brechtg111/museum-lijnvolgerV2/documenten/Eindverslag._finaledocx.docx

# Eindverslag

Museum Lijnvolger V2 | Brecht Gullentops | 2025-2026

## Opdracht

Tijdens dit project heb je niet alleen gewerkt aan een technisch eindresultaat, maar ook aan je ontwikkeling als toekomstige professional. In dit eindverslag blik je terug op het volledige traject en reflecteer je kritisch op je eigen functioneren binnen het team.

Dit verslag vormt een persoonlijke en onderbouwde reflectie op jouw leerproces. Het is geen herhaling van je technische documentatie, maar een verdieping op hoe jij het project hebt ervaren, welke keuzes je hebt gemaakt en hoe je bent gegroeid.

## Doel van deze opdracht

Met dit eindverslag toon je aan dat je:

- Bewust kan reflecteren op je eigen handelen
- Inzicht hebt in je sterktes en werkpunten
- Je ontwikkeling kan koppelen aan concrete ervaringen
- Kritisch kan terugblikken op samenwerking en projectaanpak
- Gericht kan nadenken over je verdere groei

## Link met de tussentijdse evaluatie

In je verslag wordt verwacht dat je expliciet terugkoppelt naar je tussentijdse evaluatie:

- Welke werkpunten had je toen geformuleerd?
- Hoe heb je hieraan gewerkt?
- Welke vooruitgang heb je geboekt?
- Wat blijft nog een aandachtspunt?

Deze link is essentieel en wordt meegenomen in de beoordeling.

## Belangrijke verwachtingen

Een goed eindverslag:

- Bevat concrete voorbeelden uit het project
- Is eerlijk en kritisch, niet enkel positief
- Gaat verder dan beschrijven en focust op reflectie (waarom, hoe, wat nu?)
- Toont duidelijk je persoonlijke groei

## Praktisch

- Gebruik het voorziene template
- Werk gestructureerd volgens de opgegeven onderdelen
- Zorg voor een duidelijke en verzorgde formulering

## Evaluatiecriteria

Dit verslag wordt beoordeeld op:

- Diepgang van reflectie
- Concreetheid en onderbouwing
- Inzicht in eigen functioneren
- Link met de tussentijdse evaluatie
- Professionele houding en kritische ingesteldheid

## Jouw verslag

Dit project draaide om het bouwen van een autonoom voertuig voor het Mercedes-Benz museum in Stuttgart. Het wagentje moest een zwarte lijn volgen, obstakels ontwijken en draadloos communiceren via MQTT. Technisch gezien was het een boeiend project, maar terugkijkend leer ik minstens evenveel uit hoe ik het project heb aangepakt als uit de technische inhoud zelf.

Tijdens de tussentijdse evaluatie had ik als werkpunt geformuleerd dat ik eerder had moeten beginnen met coderen in plaats van te lang te wachten op de hardware. In de tweede helft van het project heb ik dit aangepakt door parallel te werken: terwijl de PCB werd ontworpen, schreef ik al de rijlogica en de MQTT-integratie. Dat leverde merkbaar meer resultaat op in minder tijd. Toch blijft planning een aandachtspunt voor mij: ik onderschat nog regelmatig hoe lang debuggen duurt.

Een concreet moment waaruit ik veel heb geleerd, was het oplossen van de schommelende batterijmeting. Het percentage sprong willekeurig tussen 30 en 80 procent, wat het systeem onbetrouwbaar maakte. In eerste instantie dacht ik aan een fout in de code, maar na systematisch analyseren bleek het een hardwareprobleem: de motoren veroorzaakten elektromagnetische ruis op de ADC-pin. Ik heb dit opgelost met 16-sample averaging, een meetinterval van 5 seconden en een hysteresieteller voor de noodstop. Dit heeft me geleerd om bij onverwacht gedrag altijd eerst de hardware te verdenken voor ik de code aanpas.

Mijn sterkste punt tijdens dit project was het systematisch aanpakken van problemen. Wanneer iets niet werkte, zocht ik gericht naar de oorzaak in plaats van willekeurig dingen te veranderen. Dat resulteerde in duurzame oplossingen, zoals de noodstop die pas activeert na drie opeenvolgende kritieke metingen. Ik merk dat ik hierin gegroeid ben ten opzichte van eerdere projecten, waar ik sneller gefrustreerd raakte.

Een werkpunt blijft de documentatie: ik liet die te lang liggen en merkte op het einde dat GPIO-pinnummers, bestandsnamen en weerstandswaarden niet meer klopten met de werkelijkheid. Dit kostte onnodige tijd om recht te zetten. Voortaan wil ik documentatie bijhouden als een levend document, parallel aan de ontwikkeling.

Dit project heeft me geleerd dat technische kennis alleen niet volstaat. Het vermogen om gestructureerd te werken, fouten te analyseren en documentatie up-to-date te houden zijn minstens even belangrijk. Dat zijn vaardigheden die ik ook in een professionele context dagelijks zal nodig hebben.
