brechtg111/museum-lijnvolgerV2/documenten/eindevaluatie.xlsx

IoT Project
Houd er rekening mee dat alles in deze periode gebeurt onder begeleiding van een mentor en de focus in grote mate ligt op het leren en het leerproces van de student. Je houdt hiermee ook rekening bij uw beoordeling.
IoT-technicus (70% van de punten)
We evalueren de student in verschillende rollen: als IoT-technicus, als teamlid, als communicator en als groeiende professional. Elke rol omvat een aantal leerdoelen. Duid voor elk leerdoel de relevante beoordeling aan (zwak, voldoet bijna, voldoet, echt goed, overtreft de verwachtingen). Als het leerdoel niet van toepassing is in de specifieke context, duidt u N.V.T. aan. Tegen het einde van het werkplekleren moeten de opgesomde leerdoelen zoveel mogelijk aan bod komen. Na het aankruisen van de beoordelingen per doelstelling geeft u een cijfer op 10 voor elke rol. Dat cijfer is een afspiegeling van uw beoordelingen voor de onderliggende doelstellingen. Voor elke rol motiveert u de beoordelingen en het cijfer door een omschrijving te geven van de sterke punten en de werkpunten van de student. Verwijs daarbij zoveel mogelijk naar concrete voorbeelden en situaties.
 | (aanvinken)
 | zwak | voldoet bijna | voldoet | echt goed | overtreft de verwachtingen | niet van toepassing
IoT-technicus (70% van de punten)
Analyse: Je analyseert een IoT-opdracht en bedenkt, in samenspraak met klanten, gebruikers en collega-experten, één of meerdere technische oplossingen. Je selecteert en verzamelt de benodigde componenten voor deze oplossingen. |  |  |  | x
Praktische IoT-Implementatie: Je voert IoT-opdrachten uit door systemen te configureren, optimaliseren, programmeren en installeren, volgens de specificaties en wensen van de opdrachtgever. |  |  |  | x
Testen, Oplevering en Instructie: Je test IoT-systemen grondig, levert deze op en verstrekt duidelijke instructies voor een correct en efficiënt gebruik. |  |  |  | x
Onderhoud en Reparatie van IoT-Systemen: Je onderhoudt bestaande IoT-systemen en voert wijzigingen, vervangingen of reparaties uit waar nodig. |  |  | x
Cyberveiligheid en Privacy: Je waarborgt privacy en cyberveiligheid door best practices en countermeasures te implementeren. |  |  |  | x
Veiligheid, Duurzaamheid en Welzijn: Je hanteert een sterke focus op veiligheid, duurzaamheid en welzijn en past relevante reglementeringen en normen toe. |  |  |  | x
Globaal punt op 10 voor de rol van IoT-technicus :
Sterke punten : (omschrijving) | Ik ben goed In het vinden van een oplossing voor mijn probleem en niet te stoppen tot dit probleem opgelost is.
Werkpunten : (omschrijving) | Mijn plan van aanpak kan beter door een palnning te maken vanaf het begin.
 | zwak | voldoet bijna | voldoet | echt goed | overtreft de verwachtingen | niet van toepassing
Teamlid (10% van de punten)
Teamwerk en Verantwoordelijkheid: Je werkt constructief en flexibel samen in teams, neemt verantwoordelijkheid en voert gezamenlijke opdrachten uit. |  |  |  |  |  | x
Globaal punt op 10 voor de rol van teamlid :
Sterke punten : (omschrijving) |  |  |  |  |  | x
Werkpunten : (omschrijving) |  |  |  |  |  | x
 | zwak | voldoet bijna | voldoet | echt goed | overtreft de verwachtingen | niet van toepassing
Communicator (10% van de punten)
Documentatie: Je documenteert je eigen werk transparant voor interne en externe lezers/gebruikers. Je documentatie documentatie is gestructureerd, duidelijk en volgt de gangbare conventies van je team zodat een collega je werk kan overnemen. |  |  | x
Instructie: Je legt de werking van je installatie op een heldere manier uit aan interne en externe stakeholders in gesprekken en presentaties of demo’s. |  |  |  | x
Professionele communicatie: Je communiceert zowel schriftelijk als mondeling volgens de geldende professionele normen. |  |  |  | x
Globaal punt op 10 voor de rol van communicator
Sterke punten : (omschrijving) | Ik vind van mezelf dat ik goed ben in het uitleggen van het project aan mensen die er niks van kennen.
Werkpunten : (omschrijving) | Mijn documentatie kan zeker nog wat werk gebruiken.
 | zwak | voldoet bijna | voldoet | echt goed | overtreft de verwachtingen | niet van toepassing
Groeiende professional (10% van de punten)
Zelfstandigheid en Doorzettingsvermogen: Je toont zelfstandigheid en doorzettingsvermogen, staat open voor constructieve feedback en streeft naar verbetering van je werkproces. |  |  |  |  | x
Informatieverwerking en Toepassing: Je verzamelt zelfstandig informatie, beoordeelt de relevantie en toepasbaarheid ervan en integreert deze creatief in je beroepsmatige taken. |  |  |  | x
Voortdurende Professionele Ontwikkeling: Je volgt actief de trends en ontwikkelingen binnen je vakgebied en engageert je als levenslang lerende. |  |  |  |  | x
Globaal punt op 10 voor de rol van groeiende professional
Sterke punten : (omschrijving) | Ik ben altijd snel erbij om constructief commentaar te horen en dit toe te passen aan mijn project.
Werkpunten : (omschrijving) | Kan nog steeds werken aan tijdig te beginnen met mijn project en niet mijn werk uit te spreiden.
