brechtg111/museum-lijnvolgerV2/(commit log)

2026-06-04 Initial commit: Arduino lijnvolger v2 code, documenten en foto's
2026-06-04 Voeg obstakelontwijking toe en documenteer volledige codebase
    - Integreer ultrasone sensor, servo en ontwijkRechts() in lijnvolgcode
    - Fix ledcWrite-bug: pinnummers (ENA/ENB) ipv kanaalnummers gebruiken
    - Voeg WiFi + MQTT telemetrie toe (status, afstand, IR-waarden)
    - Voeg uitgebreid commentaar toe bij elke functie en parameter
    [lijnvolg_v2.ino]
2026-06-04 Voeg HTML-dashboard toe met live sensordata en bewegingslog
    - Realtime MQTT-verbinding via WebSocket (poort 9001)
    - IR-sensoren gevisualiseerd als gekleurde LED-indicators
    - Afstandssensor met kleurgecodeerde balk (groen/geel/rood)
    - Bewegingslog met tijdstempel, status, IR-waarden en afstand
    - Statistieken: berichtenteller, ontwijkingen, minimale afstand
    - Auto-scroll en log wissen
    - Mosquitto WebSocket-configuratie toegevoegd
2026-06-04 Fix eindeloos ronddraaien bij verlies van lijn na obstakeldetectie
    Vervang de oneindige pivot-zoekloop door een gefaseerde zoekstrategie:
    Fase 1 (1500ms): draai in lastDir (meest waarschijnlijke kant)
    Fase 2 (1500ms): draai in omgekeerde richting
    Fase 3: stop volledig (LIJN_KWIJT) - voorkomt eindeloos rondjes draaien
    zoekStart-timer wordt gereset naar 0 zodra een sensor de lijn opnieuw ziet.
    [lijnvolg_v2.ino]
2026-06-04 Voeg uitgebreide telemetrie toe aan obstakelontwijking
    - Nieuwe functie publishOntwijkTelemetry() met extra JSON-velden:
    stap, duur_ms, kwijt_teller, lijn_sensor
    - Elke deelstap publiceert een eigen status:
    OBSTAKEL, DRAAI_RECHTS, ZIJSTAP, DRAAI_LINKS,
    SCAN_OBJECT, NAAST_OBJECT, OBJECT_VOORBIJ, OBJECT_TIMEOUT,
    EXTRA_VOORUIT, LIJN_ZOEKEN, LIJN_HERVAT, LIJN_NIET_GEVONDEN
    - Serial.printf() logging toegevoegd voor debugging via monitor
    - lijn_sensor veld toont welke IR-sensor de lijn terugvond (L/M/R/combinatie)
2026-06-04 Vereenvoudig stap 4 ontwijking: deterministische terugkeer naar lijn
    Vervang de sensorgestuurde zachte bocht door een vaste bewegingsreeks:
    - 90° links draaien (DRAAI_90_MS)
    - SIDESTEP_MS vooruit (zelfde afstand als de zijstap in stap 1)
    Robot komt zo op de originele lijnpositie terug zonder afhankelijk
    te zijn van sensor-timing tijdens een curve.
    Stap 5 controleert daarna welke IR-sensor de lijn ziet en publiceert
    dit via telemetrie (lijn_sensor = L / M / R / combinatie / geen).
2026-06-08 voor de switch
2026-06-09 verwijder TRIM_L en TRIM_R motorbalans correctie
    [lijnvolg_v2.ino]
